danny2217/Capstone_EMBRACE/breath-sensor/HANDOFF.md

# Air-Rhythm 호흡 센서 — 다음 대화 인수인계 (2026-10-13 갱신)

> 아래 내용은 이전 Claude 대화의 작업 상태다. 이 맥락을 이어받아 지도교수 페르소나(프로젝트 지침)로 진행해 줘.
> 나는 아두이노·회로 초보라서, 장치 관리자 여는 법 수준부터 단계별 설명이 필요하다.

## 1. 프로젝트와 이번 작업 범위
- 캡스톤: ASD 아동용 스마트 압박 조끼. 이번 범위는 **가슴 스트랩 전도성 고무 인장 센서로 호흡 데이터 수집 → PC 실시간 그래프 → 보고서용 PNG**. 검출 알고리즘은 아직 범위 밖.
- 참고 레포: https://github.com/Rubi9981/Air-Rhythm (객담 배출 조끼, ESP32-S3, 대역통과 + 기울기 검출)
- 요구사항 명세서 PDF "BLE 코드 읽기 및 보드 연결" (FR-01~03, NFR, TC-01~04, 디렉토리 구조) — **같이 첨부함**

## 2. 하드웨어 / 환경 (확정)
| 항목 | 값 |
|---|---|
| 보드 | ESP32-WROOM-32 DevKit (모듈 인쇄 확인), USB 칩 CP2102, Micro-USB(5핀) |
| PC | Windows, 작업 폴더 `D:\2026-2학기\캡스톤 디자인(1)\Air-Rhythm` |
| Arduino IDE | 2.3.10, 보드 **ESP32 Dev Module**, ESP32 코어 **3.x** (2.0.17 아님) |
| 포트 | **COM5** = CP2102 (드라이버 설치 완료). COM3·COM4 는 블루투스 가상 포트 — 쓰면 안 됨 |
| Python | 3.11, matplotlib 3.10.9, pyserial 3.5 |
| 배선 | 센서 한쪽 → D32(GPIO32), 다른 쪽 → GND. 외부 저항 없음(내부 풀업) |

## 3. 코드 구조 (Air-Rhythm.zip)
```
firmware/sensor_reader/
  sensor_reader.ino   setup/loop 만 (Arduino 자동 prototype 문제 회피용으로 분리)
  sensor_app.h/.cpp   실제 구현. 50 Hz FreeRTOS 태스크(vTaskDelayUntil), ADC 8회 오버샘플,
                      이동평균 10샘플, 단선/단락 판정, 풀업 레지스터 직접 확인,
                      cfg::USE_INTERNAL_PULLUP 스위치(외부 풀업 전환용), 비-ESP32 보드면 #error
software/visualizer.py  --port COMx 실시간 그래프+CSV / --demo / --replay CSV → PNG / --list
                        수신 데이터로 ADC 포화(≥3000 mV)·단락 경고 표시
software/requirements.txt, README.txt
data/DEMO_simulated_breath.csv          모의 데이터 (실측 아님)
report_images/DEMO_*.png                모의 데이터 그래프 (실측 아님)
```
시리얼 출력: `seq<TAB>t_ms<TAB>mv<TAB>ma_mv`, `#` 줄 = 진단 (`# fs=...`, `# WARN ...`, `# pullup_register=ON/OFF`)

## 4. 진행 상황
- [x] 컴파일·업로드 성공 (코어 3.x 경로 실사용 검증됨)
- [x] 시리얼 수신 확인: `# fs=50.00Hz avg=20000us min=19991us max=20009us` → 주기 오차 ±9 µs
- [x] 센서 미연결 시 3145 mV 고정 (ADC 상한)
- [x] 파이썬 실시간 그래프 동작: 수신 50.7 Hz, 유실 0
- [x] 모의 데이터로 그래프·필터 전후 비교 PNG 생성 (팀원 공유용, "모의 데이터" 표기)
- [ ] `# pullup_register=ON` 줄 캡처 (TC-01 증빙) — EN 버튼 → 자동 스크롤 끄고 위로 스크롤
- [ ] 새 센서 저항 Ra(착용)/Rb(최대 들숨) 기록 → 풀업 결정
- [ ] 실측 호흡 파형 (TC-03), replay PNG (TC-04 실측판)
- [ ] 측정 프로토콜 × 3회 × 피험자(팀원) 2~3명 → --analyze 결과표

## 4-1. 2026-10-13 변경 (visualizer.py)
- 인장 센서 교체 완료(사용자 보고). 저항값(이완/인장)은 아직 미기록 → README 5절 기준으로 풀업 결정.
- 실시간 창 숫자 키 1~5 로 측정 구간 표시 → CSV `phase` 열 (구 CSV 도 replay/analyze 호환)
- `--analyze CSV [--count N]`: 동작점·포화·진폭(P5–95)·노이즈 σ(숨 참기)·SNR·호흡수(스펙트럼+사이클) + 잠정 판정. 합성 데이터로 검증(15 bpm, 진폭 79 mV 재현)
- `--invert`: y축 반전 (늘리면 전압이 내려가는 센서용)
- 버그 수정: 's'/'p' 가 matplotlib 기본 단축키(저장 대화상자 / pan)와 충돌 → 기본 바인딩 제거
- 버그 수정: --demo 신호의 호흡수가 위상 계산 오류로 크게 흔들리던 문제 (기존 DEMO_*.csv/png 는 구버전 생성물)

## 5. 현재 문제 (우선순위 순)
1. **센서 파손**: 손으로 늘려보다 고무줄이 끊어짐 → 교체 센서 필요. 최대 신장률·내구성을 사양으로 기록할 것 (아동용 조끼 안전 요구사항과 직결).
2. **동작점 포화**: 센서를 연결해도 3145 mV(ADC 상한)에 붙어 호흡에 반응 없음. 손으로 세게 당겨야만 움직임.
   - 추정 원인: 센서 저항 ≫ 내부 풀업(약 45 kΩ, 칩마다 30~80 kΩ) → V = 3.3·Rs/(Rs+Rpu) 가 상한 초과. 또는 접촉 불량.
   - 소프트웨어 증폭으로는 해결 불가 (잘린 신호).
   - 미결정 선택지: **A** 측정 구간(클립 간격) 5~10 cm로 단축 / **B** 외부 풀업 저항 R≈Rs (`USE_INTERNAL_PULLUP=false`, 명세서 수정 필요, 교수 권고안) / **C** 미리 당겨 감기(늘리면 저항이 줄어드는 센서일 때만).
3. **저항 변화 방향 미확인**: 당겼을 때 mV가 상한에서 내려온 것으로 보임 → 늘리면 저항이 줄어드는 센서일 가능성. 확인 필요.
4. 명세서 정리 필요: "외부 저항(예: 10옴)" 오기(10 kΩ?), 제목은 BLE인데 범위는 시리얼.

## 6. 다음 대화에서 하고 싶은 것
- 새 센서 저항 측정(멀티미터: 이완/인장) 결과로 A/B/C 결정 → 필요 시 펌웨어 수정·재업로드
- 실측 호흡 측정 절차(정지 10 s → 심호흡 3회 → 평상 호흡 1분 → 숨 참기 10 s) 진행, 진폭·노이즈·SNR 정량화
- 교수 질문에 답하기: 전조 감지→가압까지 허용 지연 예산과 필터 지연(현재 이동평균 군지연 약 90 ms) 배정

## 7. 이 문서와 함께 첨부할 파일
1. `Air-Rhythm.zip` (최신 코드 전체 — 내 PC 폴더를 압축해도 됨)
2. 요구사항 명세서 PDF
3. 새 센서 저항 측정값 (이완 / 인장, Ω) — 측정 후
4. 시리얼 모니터 캡처 (`# pullup_register=...` 줄, `# fs=...` 줄)
5. 실측 그래프 캡처 또는 `data\breath_*.csv` — 측정 후
6. 에러가 나면: 출력창 첫 번째 `error:` 줄 전체
