danny2217/Capstone_EMBRACE/(commit log)

2026-10-16 feat(breath-sensor): 호흡 센서 펌웨어 및 시각화 도구 추가
2026-10-22 README 작성, detector.py 추가, .gitignore 파일명 수정
2026-11-06 앱 추가
2026-11-06 Revert "앱 추가"
    This reverts commit 1edb9318c35f5a16b884e5e828c17bad9d99ba68.
